Jaycar-Electronics/Solar-MPPT-Charge-Controller/images/breadboard.jpg

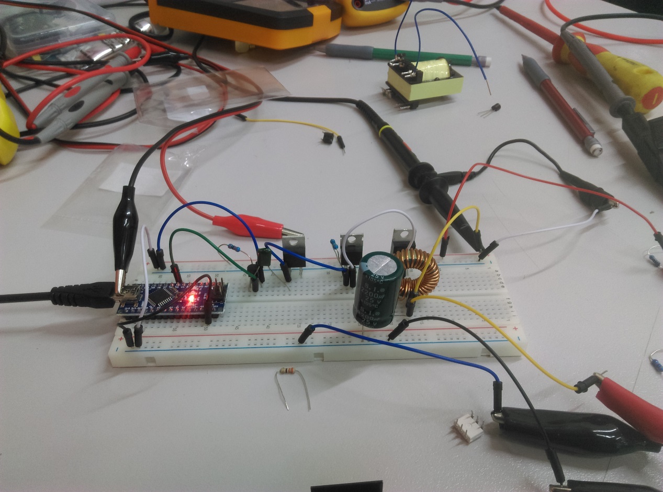
images/breadboard.jpg
