Jaycar-Electronics/Solar-MPPT-Charge-Controller/images/encoder.png

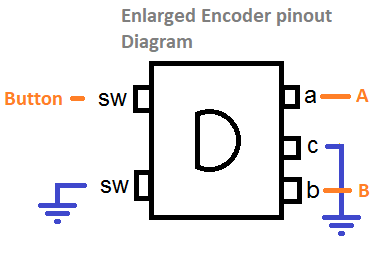
images/encoder.png
