Jaycar-Electronics/Solar-MPPT-Charge-Controller/images/front.jpg

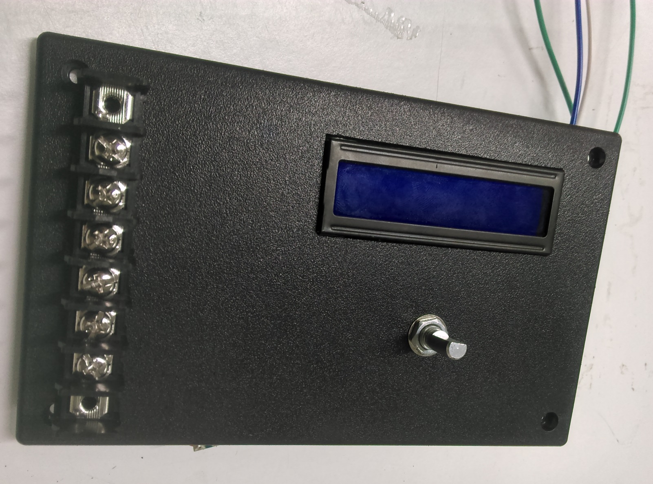
images/front.jpg
