Jaycar-Electronics/Solar-MPPT-Charge-Controller/(threads)

Thread 1 (2019-06-24):

Encoder use

Yea57CW, 2019-06-24:
Hi,
I may be missing something in the instructions but understand the project but not the use of the encoder, is it to change modes not explained in the text?

Jaycar-Electronics, 2019-07-02:
It can be used to activate and change menu options but under time we didn't get to fully implement the menu; It's something "on the todo list" but if you want to submit a pull request feel free and we can approve it.

Thread 2 (2019-06-24):

What size solar panel and battery will it support

rover109, 2019-06-24:
I'm fascinated by this simple MPPT controller and want to build it for my own education. But unless I've missed it, nowhere in the documentation does it say what size solar panel or battery it is capable of controlling. Can somebody clarify?

Jaycar-Electronics, 2019-07-02:
Generally "not too large"

If you want a proper MPPT it will be much more cheaper, effective, and longer lasting to buy a proper off the shelf one; This one is more as a demonstration; say a 5W 12V panel, and a small 12V battery;

As for how well it will work in these setups, we don't have to much information; but feel free to experiment and let us know of improvements if you see them

Thread 3 (2019-07-10):

CX500

CX500, 2019-07-10:
I note that the subject Solar-MPPT-Charge-Controller explains the function of the inductor L1 as being there to smooth out the electric current heading for the battery.  It says:

"_Then from the source to the drain of the mosfet, we output via an inductor (or Choke) and capacitor to give us smoother experiences on the battery side of things; There is a protection diode between the choke and the Mosefet so there is no harsh EMF voltage from the coil_,"

But, Isn't the inductor L1 and the associated diode actually functioning as a Boost converter, to raise the voltage level as required by the microcontroller, so as to match the optimum voltage/current point?  That is my limited understanding of how MPPT charge controllers work.

Any feedback to this comment?

matty0005, 2019-07-28:
The purpose of the inductor, L1 and its associated diode is to form a 'buck' converter (step down). By changing the duty cycle of the PWM signal at the gate of the MOSFET, it ultimately allows us to change the incoming voltage and consequently current to allow us to obtain the MPP.

Technically the inductor is smoothing out the current of the system, while the capacitor is there to smooth out the voltage.

You can technically replace the diode with another 'switch' to allow current to flow (from the Inductor and Capacitor) while the MOSFET is off. You could use another MOSFET to create a synchronous buck converter, otherwise, the properties of a diode work as well while decreasing complexity. Without this, you would also get 'harsh' voltage spikes which can destroy other components if you are not careful.

Thread 4 (2019-08-11):

Does this work at all?

BurntChip, 2019-08-11:
This project appears to have many issues.
1.Your schematic shows an N-ch mosfet.
2.Strange gate gate drive circuit, why not use the BJT to ground the gate and turn the mosfet on.
3.No resistor at the base of the BJT = burnt arduino pin.
4.Pin D2 does not appear to be a PWM pin. Connection diagram shows D3.
5.At the standard PWM frequency, the inductor will saturate at duty cycle = 5.
6.Parts list, schematic and photos are inconsistant.
and more.

BC.

Jaycar-Electronics, 2019-08-12:
1. Yes, this has been corrected, The error came from EAGLE software.
2. So there is not a large voltage swing on the gate; This actually comes as an improvement; as the BJT does not need to be connected to the `vin` source; it *is* at the moment, but it doesn't have to be.
3. Yes, resistor is missing from schematic, it usually fits under the nano. I've admended some images and text.
4. 3 it is; this has been fixed.
5. Can you confirm what you mean by this?

We appreciate kindly your contribution. The above errors have been fixed in the latest commit; If you have suggestions or improvements feel free to submit a pull request and we're happy to take a look at it;

Closed 2019-08-12.

Thread 6 (2021-10-31):

Values of R1, R3, R4 missing

au-chrismor, 2021-10-31:
The schematic shows these components without values.  Parts list shows 1M, 10K and 91K resistors (1 pack each), but there is no association between them.  Presumably 2x10K in parallel makes up R5 since there's no suitable entry in the parts list.

Luban666, 2022-03-07:
you need calculate it, It related to the ardunio ADC voltage, eg, your battary is 24V, your ADC is 5V for max, your voltage divid must get 5V, and the value of resister must be high since you do not want waste too much power on this part , it is a measure part, not a work part

mjolnir71, 2022-04-23:
Seems like someone stopped working on this before it was finished. Seems like R1 should probably be 10K, R3 and R4 should be providing the A/D input with whatever voltage the software expects, which will have to be between 0 and 5 volts, I would have designed for about 2.5V with the battery at about 12, but I haven't got that far into the code yet. The code is also very incomplete, it does not display any actual numbers on the LCD, and the rotary encoder is not implemented.
John

Luban666, 2022-04-23:
>

I did similar things and yeah, the 10k still to high since we only need a voltage 1M may more suitable

mjolnir71, 2022-04-23:
The way I see it, when the BC547 pulls low the capacitor will charge via the diode, so the gate of Q1 will quickly turn off. But when the collector of the transistor goes high R1 (10k?) will hold one end of it at the potential of the positive line. The other end will now be higher, by the amount that it was charged by, and will turn on the MOSFET. That charge will tend to leak away via the circuit R1 and R2, but R2 is 1 MOhm, giving a reasonable time constant before leakage would turn the gate off again. So R1 doesn't need to be an especially high value, but of course should not be too low.
Anyway, having just got my mistakes corrected enough that I was seeing drive to the gate, something managed to touch that shouldn't have, so now I have put it aside until I get a new Arduino. I have a few others, but they are in projects that I don't want to disturb.  (I'm using a pro mini clone, which changes the layout of that part, but is otherwise the same.)
regards
John

au-chrismor, 2022-04-23:
Now that things have settled down for me, I am going to go back and revisit this one.

Agreed with the comments for component values, and I would like to at least get the display to show something meaningful.  It looks to me like the version of software which was photographed for the article is not the same as the version on here.  But that shouldn't stop us from figuring it out.
